JK-Future-GitHub/R2D2/png/R2D2_side.png

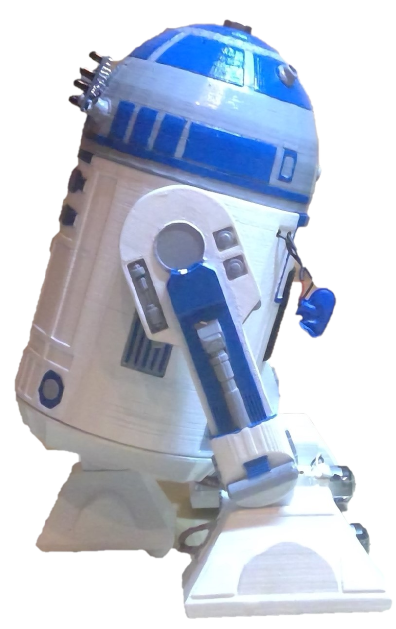
png/R2D2_side.png
