JK-Future-GitHub/R2D2/R2D2_doku_german.pdf

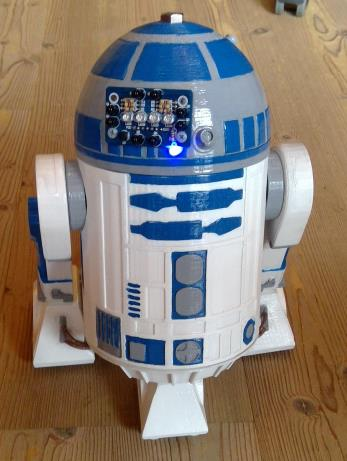
[picture p3: figure]

Bei meinen MCT-Projekt „R2D2“ habe ich mich optisch, wie auch aus technischer Sicht, an den

originalen Roboter aus den „Star Wars“ Filmen orientiert. Bei der Konstruktion handelt es sich,

um lackierten 3D-Druck. Die Elektronik, die den Roboter Leben ein verhaucht, wird zentral

über einen programmierten Mikrocontroller gesteuert. Dieser lässt sich via Bluetooth mit ei-

nen Smartphone verbinden und durch einer kompatiblen App ist es möglich den „R2D2“ steu-

ern.

Knauer Johannes

24.4.2018

R2D2

Nachbau des Originals

R2D2

Knauer Johannes | 1 von 23

## Inhaltsverzeichnis

## 1. Beschreibung der Idee

Bei der Ideenfindung war mir direkt klar, dass mein Projekt etwas mit Star Wars zu tun haben

muss, da ich ein Fan dieses „Universums“ bin und mit Hilfe eines Mikrocontrollers nachbauten

von Raumschiffen oder Robotern möglich sind. Zuerst war ein Landgleiter der Räder und Mo-

toren besitzt angedacht. Unteranderem sollte eine Objektverfolgung mit Hilfe eines speziellen

Sensors und einiger Programmierlogik realisiert werden. Des Weiteren steckte ich mir das Ziel,

den Gleiter mit ein Smartphone zu steuern.

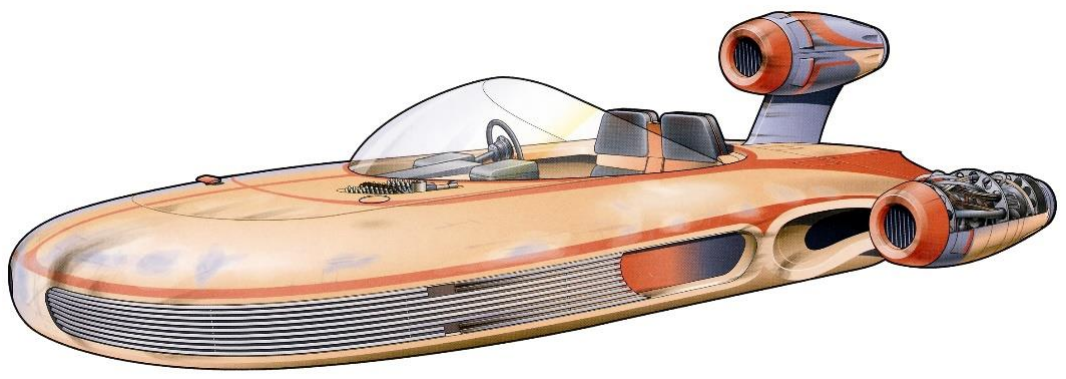
[picture p4: figure]

Abbildung 1: „Luke´s Landgleiter“

Es hat sich aber herausgestellt, dass der Landgleiter zu wenig Platz für alle Bauteile hatte, des-

halb musste eine neue Idee her. Auf der Internetseite www.thingiverse.com bin ich auf einen

rein mechanisch gesteuerten „R2D2“ gestoßen. (ChaosCorTech, 2018)

Dieser „R2D2“ wurde mit Hilfe eines 3D-Druckers hergestellt, die nötigen Informationen bzw.

Dateien stehen für jedermann zum Download bereit. Da mein Schulkollege, Blaufelder Daniel,

über so eine Vorrichtung verfügt, half er mir bei Umsetzung der Konstruktion und druckte mir

alle benötigten Bauteile.

Bis zur Fertigstellung dieser, beschäftigte ich

mich mit den elektrischen Bauteilen und ihrer

Programmierung. Durch den Bau zweier Pro-

totypen testete ich alle Bauteile, dadurch fie-

len mir weitere Funktionen ein, die ich um-

setzten könnte. Nach der Fertigstellung aller

zu druckenden Teilen, der Lackierung, den Zu-

sammenbau, der Verkabelung und Änderung

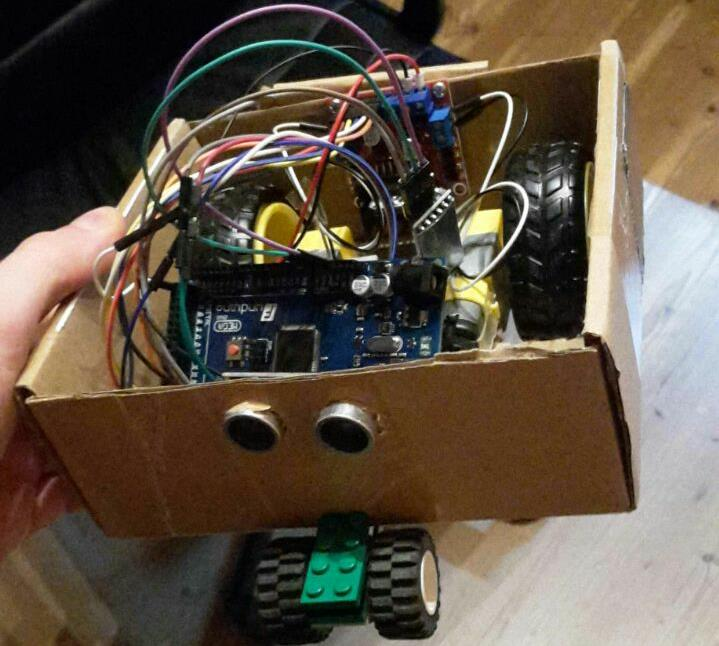
[picture p5: figure]

Abbildung 2: “Prototyp 1 von 2“ | vieler Kleinigkeiten verging eine Menge Zeit.

Doch schlussendlich erreichte ich alle Ziele/Funktionen die ich mir gesteckt habe.

Die Ziele waren:

- Via Bluetooth und Smartphone den „R2D2“ steuern
- Antrieb mit zwei DC-Motoren über die „H-Bridge/L298N“ regeln
- Objektverfolgung durch den „IR-Compound-Sensor“
- RGB-Led integrieren
- Kopfbewegungen mit den Servomotor „Tower Pro/MG995“ realisieren
- Die typischen Geräusche des „R2D2s“ über einen Lautsprecher ausgeben
- Mit den SD-Card-Reader die Geräusch-Dateien zur Verfügung stellen
- Optisch den Original so nahe wie möglich kommen

Als besonders „Zeitfressend“ stellte sich das lackieren, das Zusammenbringen aller elektri-

schen Bauteile und ausbessern von Kleinigkeiten heraus.

## 2. Funktionsbeschreibung

Der Bediener sendet Befehle über sein Smartphone an den Bluetooth-Empfänger bzw. den

Arduino-Board. Dort werden diese Signale verarbeitet und die zugeordneten Aktionen ausge-

führt.

Um die Funktionsweise bzw. die Logik hinter den komplizierteren Aktionen leichter zu verste-

hen, werde einige Bilder folgen. Aber zuerst ein paar Worte zu den „einfacheren“ Funktionen.

Die Funktion „Geräuschausgabe“ wird aus der Kombination des SD-Karten-Lesers und den

Lautsprecher realisiert.

Der Mikrocontroller bekommt die nötigen Informationen zur Geräuscherzeugung von der SD-

Karte und sendet die dementsprechenden Signale Richtung Lautsprecher.

Die „leuchtenden RGB-Led“ ist sehr simple, denn je nachdem welcher Pin „High“ ist, ändert

die Led ihre Farbe (Quellcode Zeile: 287-318).

Das Antriebssystem des „R2D2“ wird durch zwei DC-Motoren und einen Servomotor realisiert.

Antriebssystem:

→ siehe (QZ = 1-7)

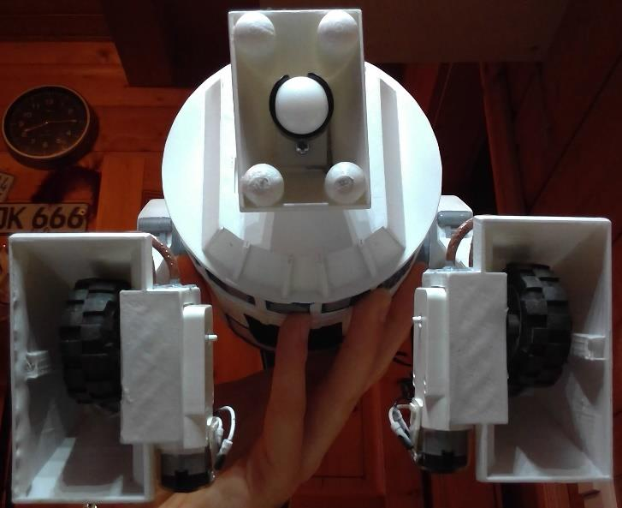
[picture p6: figure]

Abbildung 3: „DC-Motoren mit Räder und kugelförmiger Fuß“

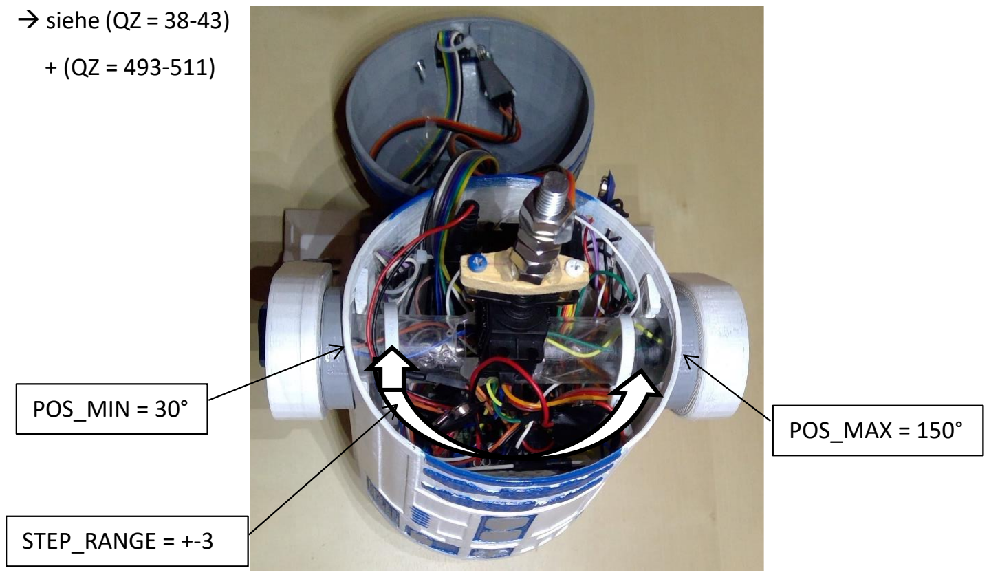
[picture p7: figure]
→ siehe (QZ = 38-43); POS_MIN = 30°; POS_MAX = 150°; STEP_RANGE = +-3

Abbildung 4: „Servo in Grundstellung = 90°“

Durch die Kombination des „Antriebssystems“ und des „IR-Compound-Eye“ kann eine Objekt-

verfolgung realisiert werden. Das „IR-Compound-Eye“ sendet mit seinen Infrarot-Leds ein kur-

zes Signal. Danach misst es die Konzentration der Strahlen, die vom Objekt zurück reflektiert

werden. Die unterschiedlichen positionierten Infrarotsensoren detektieren diese. Bei keinem

Infrarotanteil bekommt der Mikrocontroller die Signalstärke „0“ geliefert, bei maximaler

„1023“. (Analoger Eingang)

→ 1023 Objekt direkt vor den Sensor

→ 500 Objekt ca. 8-10cm entfernt

→ siehe (QZ = 23-31, 374-415)

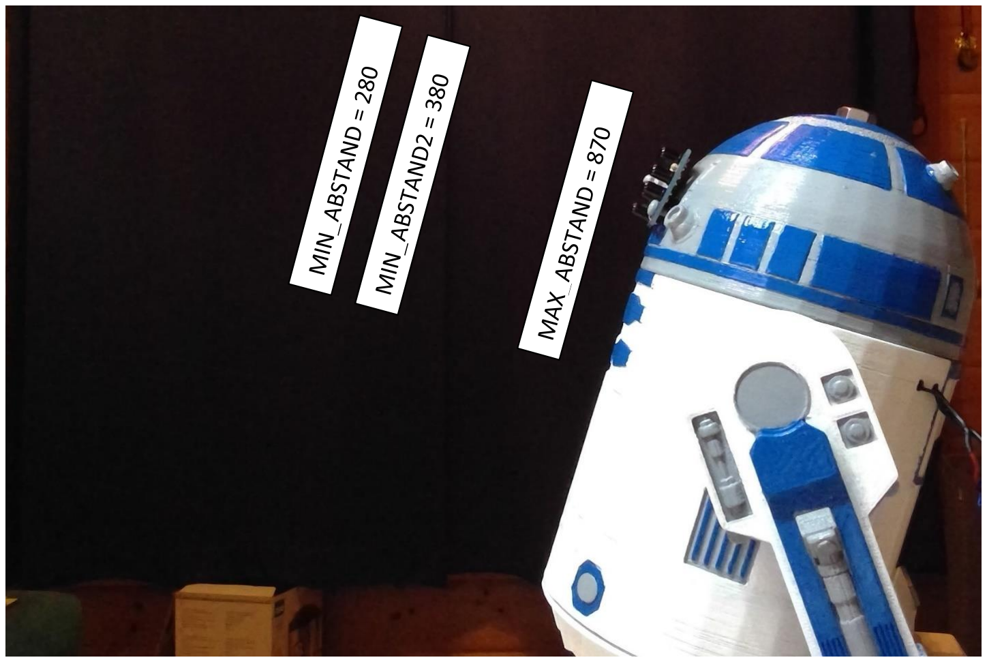
[picture p8: figure]

Um die Methode „followObject()“ (QZ = 374-415) leichter zu verstehen ist es hilfreich, sich die

Bilder und Variablen anzuschauen und mit den if-Abfragen bzw. den Bedingungen aus den

Quellcode bildlich zu verknüpfen.

Abbildung 5: „Abstände Objektverfolgung“

## 3. Beschreibung der Schaltung

Die Schaltung wurde im Programm „Fritzing“ angefertigt. Ich entschied mich dafür mehrere

Fritzing-Dateien anzufertigen. Zum einen, weil es bei so vielen Bauteilen/Leitungen sehr un-

übersichtlich wird. Zum anderen, weil das Programm immer wieder abstürzte, wenn ich alle

Bauteile in eine Schaltung zusammenbringen wollte. Deshalb fertigte ich vier Fritzing-Schal-

tungen an:

→ SD-Card-Reader

→ HC-05 + RGB LED

→ IR-Compound-Eye + H-Bridge

→ Lautsprecher + Servo

Der Verwendete „Arduion Mega 2560“, wie auch die „H-Bridge“ werden von einer 9V Block-

batterie mit Energie versorgt. Einige „GND“ und „5V“ Anschlüsse sind in der Realität verlötet,

das hat aber keinen Einfluss auf irgendwelche Funktion. Die vier kleinen Fritzing-Schaltungen

ergeben zusammen eine große. Der Quellcode ist sehr gut beschrieben, deshalb werde ich des

Öfteren darauf verweisen. Im Anschluss werde ich einige Besonderheiten ansprechen:

→ SD-Card-Reader:

Wenn man einen SD-Karten-Lesegerät verwendet, muss man je nach Mikrocontroller-Model

darauf achten, welche Geräteanschlüsse man auf welchen Mikrocontroller Pin setzt.

Arduino Mega 2560: (admin, 2018) (Quellcode Zeile: 49, 56-59)

→ Pin 53 = CS | → Pin 52 = SCK | → Pin 51 = MOSI | → Pin 50 = MISO

→ HC-05 + RGB LED:

Es gibt zwei verschiedene Ausführungen der RGB-Led, die eine hat eine Kathode, die Andere

eine Anode. Bei diesem Projekt handelt es sich, um die erst genannte. (Funduino, 2018)

(QZ: 61-66) Der Bluetooths Sender und Empfänger „HC-05“ hat zwei besondere Kommunika-

tionsanschlüsse. Den „TX“ und den „RX“ Anschluss. (Funduino, 2017) (QZ: 11-12)

→ Pin RX0 = TX → Pin TX0 = RX

→ IR-Compound-Eye + H-Bridge:

Die „H-Bridge“ kann zwei DC-Motoren gleichzeitig ansteuern. (Tech, Youtube, 2017) (QZ: 1-7)

Das „IR-Compound-Eye“ ist sehr Lichtempfindlich, da es selbst mit Infrarotstrahlen arbeitet.

(Robotrus, 2018) (QZ: 16-21)

→ Lautsprecher + Servo:

Der Servo „Tower/MG995“ ist ein Servo mit einer hohen Momenten Leistung, deshalb benö-

tigt er eine externe Energiequelle. (Funduino, 2018) (QZ: 38, 93) Der Lautsprecher zeigt Ge-

meinsamkeiten mit der SD-Karten-Erkennung, da dieser auch einen exakt vorbestimmten Aus-

gabe Pin benötigt und dieser wiederrum Modelabhängig ist. (GitHub, 2018)(QZ: 50, 52-54)

→ Mögliche Ausgabepins = 5|6|11|46

## 4. Beschreibung des Quellcodes

Der beiliegende Quellcode ist meiner Meinung nach sehr gut beschrieben. Die Kommentare

verraten beinahe alles über das Programmierte. Trotzdem werde ich noch genauer auf die

Bibliotheken, ihre Besonderheiten/Methoden und den ein oder anderen „Zeitfresser“ anspre-

chen. Die Pin-Belegung wurde teilweise von dem Mikrocontroller-Model oder von verwende-

ten Bibliotheken vorgegeben. (siehe < TMRpcm.h >)

Bibliotken und ihre Methoden:

→ <Servo.h> (Margolis, 2018) (QZ: 35)

Es kann ein „Servo-Objekt“ erzeugt werden mit dem man Methoden ausführen kann. (QZ: 36)

Zum Beispiel:

(QZ: 93)→ .attach(); Hier wird den Servo eine Steuerleitung zum Arduino-Board zugeteilt.

(QZ: 94)→ .write(); Hier wird den Servo ein Zielposition zugeteilt, die er anfährt. Dabei ist da-

rauf zu achten, dass der Servo eine Verfahr Zeit hat.

(QZ: 210)→ .read(); Hier wird die aktuelle Position des Servos ausgelesen.

Eine Besonderheit von der „write()“-Methode ist es, dass eine externe Variable mit den Inhalt

der runden Klammern beschrieben wird. Wenn die „read()“-Methode den aktuellen Wert aus-

lesen will, „checkt“ sie nicht den aktuellen Winkel des Servos, sondern nur die externe Vari-

able. Es kann zu Ablauffehlern kommen! (Mögliche Lösung: Verfahr Zeiten)

→ <SD.h> (SparkFun, 2018) (QZ: 52)

Es kann eine SD-Karte ausgelesen und Methoden ausgeführt werden.

Zum Beispiel:

(QZ: 99-105)→ SD.begin(CS); Hier wird der CS-Pin angesteuert, dadurch wird überprüft, ob

eine SD-Karte vorhanden ist. *Siehe „Beschreibung der Schaltung“ →SD-Card-Reader

(QZ: 47-49)→ In diesen Quellcode Zeilen gehe ich näher auf einige Besonderheiten zur SD-

Karten Formatierung und Liederkonvertierung ein. (Tech, YouTube, 2018) (audio.online-

convert, 2018)

→ <TMRpcm.h> (GitHub, 2018) (QZ: 53)

Es kann ein „Lautsprecher-Objekt“ erzeugt werden mit dem man Methoden ausführen kann.

(QZ: 54)

Zum Beispiel:

(QZ: 97)→ .speakerPin; Hier wird das Attribut „speakerPin“ des „Lautsprecher-Objektes“ eine

Steuerleitung zum Arduino-Board zugeteilt.

*siehe „Beschreibung der Schaltung“ → Lautsprecher + Servo

(QZ: 98)→ .setVolume(5); Hier wird die Lautstärke des Lautsprechers festgelegt mit „5“. Der

Minimalwert ist 0 und der Maximalwert ist 7.

(QZ: 197)→ .play(); Hier kann eine Datei von der SD-Karte abgespielt werden. Aber Achtung,

je nach Stand der Bibliothek, die man herunterlädt, darf der Dateiname nicht länger als 8 Zei-

chen sein.

(QZ: 320)→ .isPlaying(); Hier kann überprüft werden, ob sich der Lautsprecher aktuell im

Wiedergabemodus befindet, oder schon damit fertig ist.

Die Bibliothek hat eine Besonderheit, die man nicht übersehen sollte, denn wenn man einmal

die Methode „play()“ ausführt, werden die PWM/Timer 1 ,2 und 3 ausgeschaltet, um Störge-

räusche zu vermeiden.

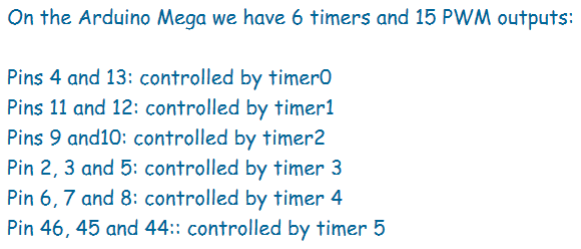
[picture p9: figure]

Abbildung 6: „PWM-Timer-Pins“

Das hat zur Folge, dass diese Pins im Anschluss nutzlos sind. Dies Besonderheit hat sich bei

meinem Projekt als echter „Zeitfresser“ erwiesen.

Hinweis: Ab der Quellcode Zeile „514“ befindet sich ein Methodenverzeichnis.

## 5. Bedienungsanleitung

Der „R2D2“ wird, wie schon erwähnt, über das Smartphone gesteuert. Die App die ich be-

nutzte heißt „Arduino bluetooth“. Der Aufbau der App

ist fast selbsterklärend. Nach der Installation und öff-

nen der App, wird man aufgefordert sein Bluetooth zu

aktivieren. Jetzt stellt man die Verbindung zum Blue-

tooth-Empfänger her. (HC_05)

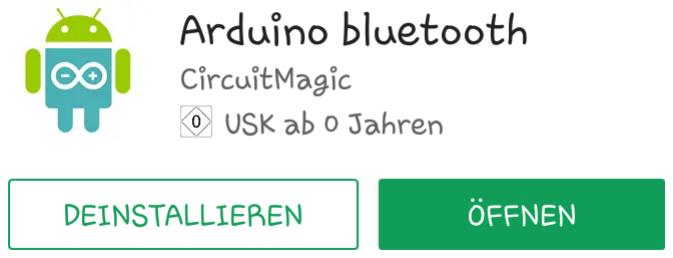
[picture p10: figure]

Man hat nun die Auswahl zwischen vier

Menüpunkten. (QZ = 114-118)

Der Quellcode bezieht sich nur auf die

Menüpunkte „Control pad“ und „But-

tons“.

Abbildung 7: „Arduino bluetooth“

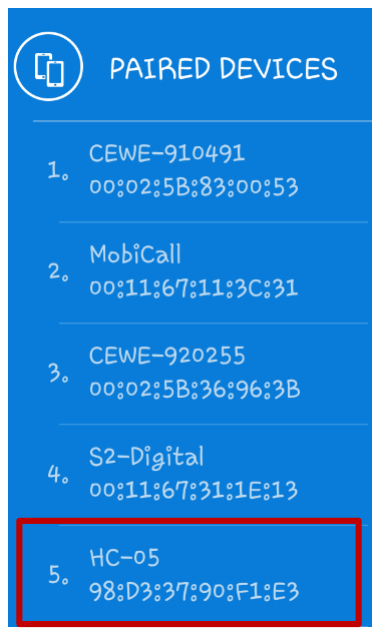
[picture p11: figure]
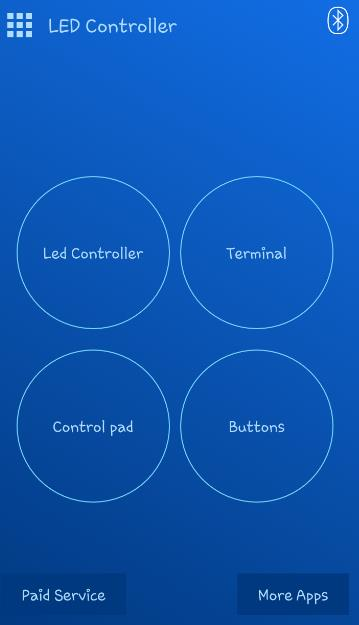
[picture p12: figure]

Abbildung 8: „Menü“ Abbildung 9: „Kopplungsmenü“

Menüpunkt „Control pad“: → siehe (QZ = 141-175)

Durch einen Klick auf das Bluetooth-Zei-

chen, kann die Verbindung getrennt

werden.

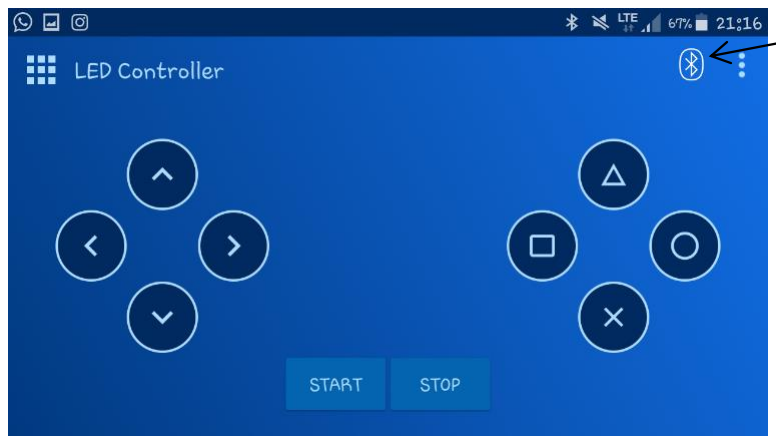
[picture p13: figure]

Bei einem Klick auf den Button mit den drei senkrecht zueinander laufenden Punkten, stellt

man die Zeichen, je Button ein. Jede Taste ist mit einem Zeichen hinterlegt.

→ Beispiel: - Abbildung 11: „Button Einstellung“

Menüpunkt „Buttons“: → siehe (QZ = 176-188)

Abbildung 10: „Control pad“

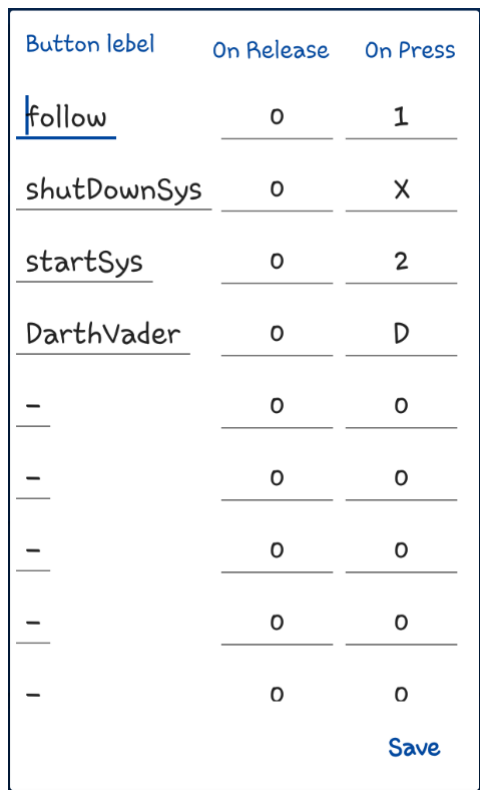
[picture p14: figure]
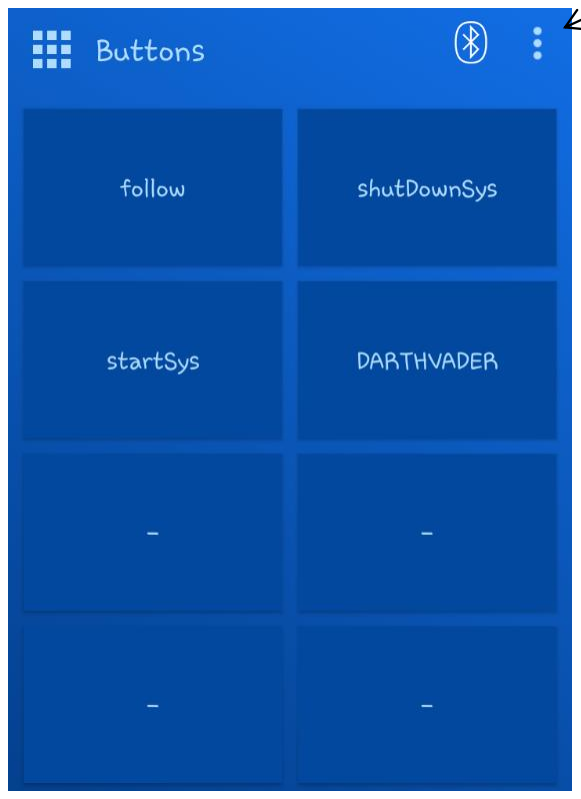
[picture p15: figure]

Abbildung 12: „Buttons“ | Abbildung 11: „Button Einstellung“

## 6. Quellenverzeichnis

### 6.1. Literaturverzeichnis

admin. (23. Februar 2018). Bajdi.com. Von http://www.bajdi.com/arduino-mega-2560-andsd-card-modul/ abgerufen

audio.online-convert. (19. Januar 2018). Von https://audio.online-convert.com/convert-towav abgerufen

ChaosCorTech. (17. Januar 2018). Thingiverse. Von https://www.thingiverse.com/thing:1205821 abgerufen

Funduino. (15. Dezember 2017). Von https://funduino.de/tutorial-hc-05-und-hc-06-bluetooth abgerufen

Funduino. (15. März 2018). Von https://funduino.de/nr-20-rgb-led abgerufen

Funduino. (19. Januar 2018). Von https://funduino.de/nr-12-servo-ansteuern abgerufen

GitHub. (19. Januar 2018). Von https://github.com/TMRh20/TMRpcm/wiki abgerufen

Margolis, M. (20. Januar 2018). ArduinoCC. Von
https://www.arduino.cc/en/Reference/Servo abgerufen

Robotrus. (15. Januar 2018). Von https://www.robot-r-us.com/sensor-infrared/ir-compoundeye.html abgerufen

SparkFun. (23. Februar 2018). ArduinoCC. Von https://www.arduino.cc/en/Reference/SD abgerufen

Tech, M. A. (15. Dezember 2017). Youtube. Von https://www.youtube.com/watch?v=Da4HY7HZ6h0 abgerufen

Tech, M. A. (20. Februar 2018). YouTube. Von https://www.youtube.com/watch?v=gi9mqIha8n0 abgerufen

### 6.2. Bilderverzeichnis

## 7. Anhang

### 7.1. Quellcode inkl. Zeilenzahlen

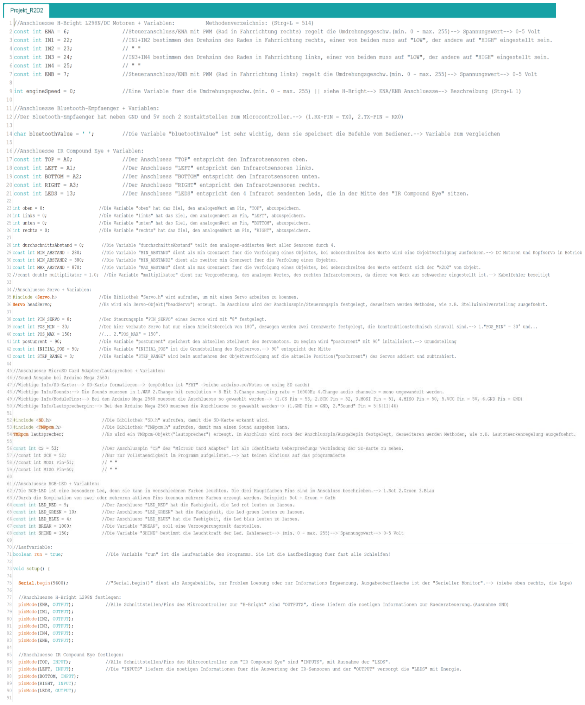
[picture p16: figure]

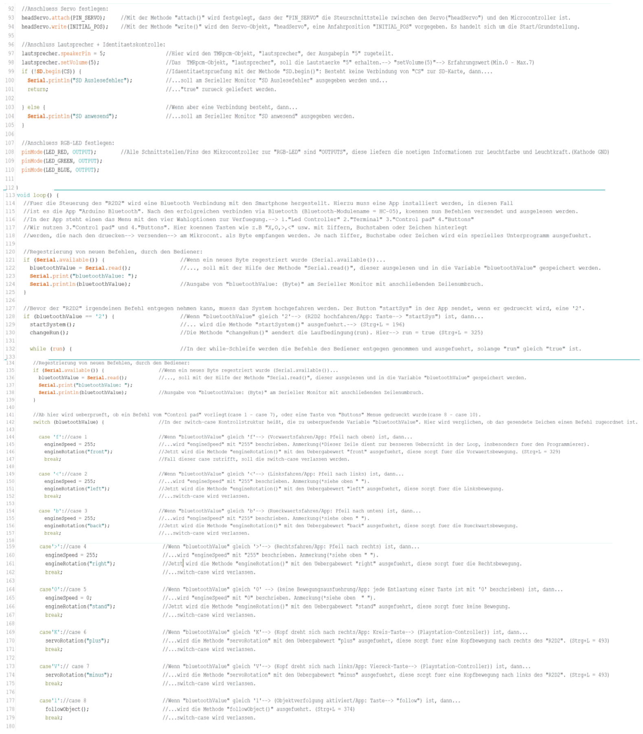
[picture p17: figure]
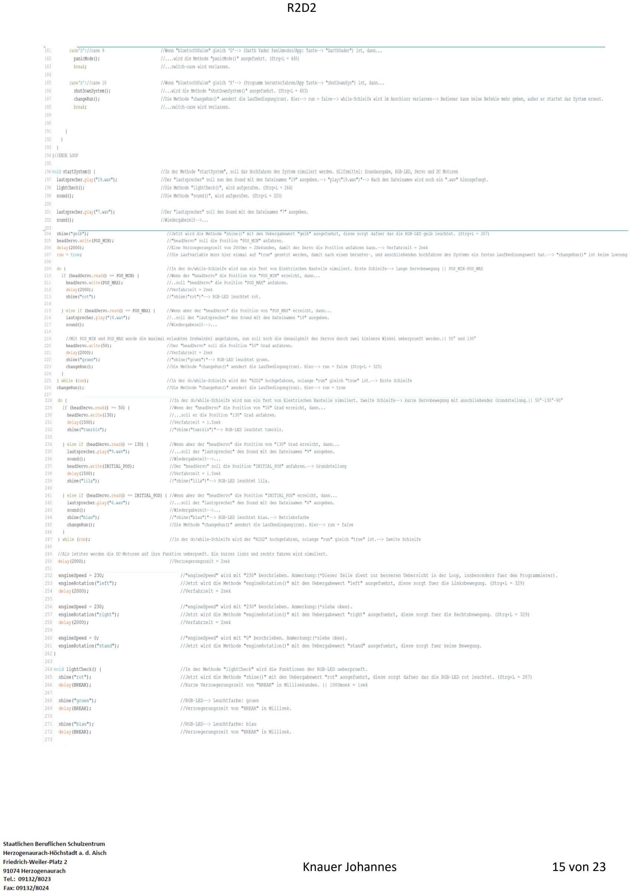
[picture p18: page 16]
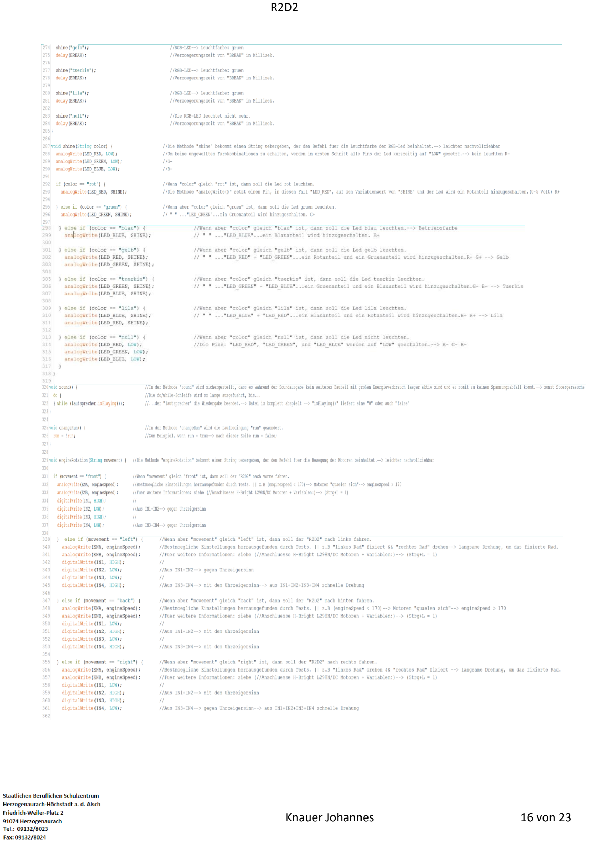
[picture p19: page 17]

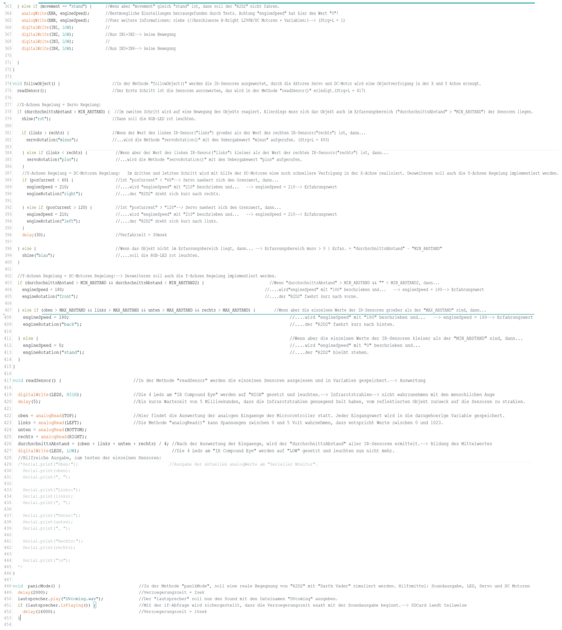
[picture p20: figure]

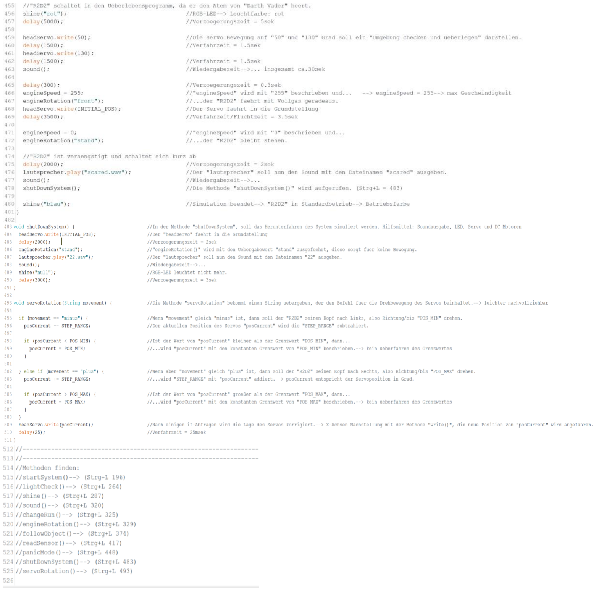
[picture p21: figure]
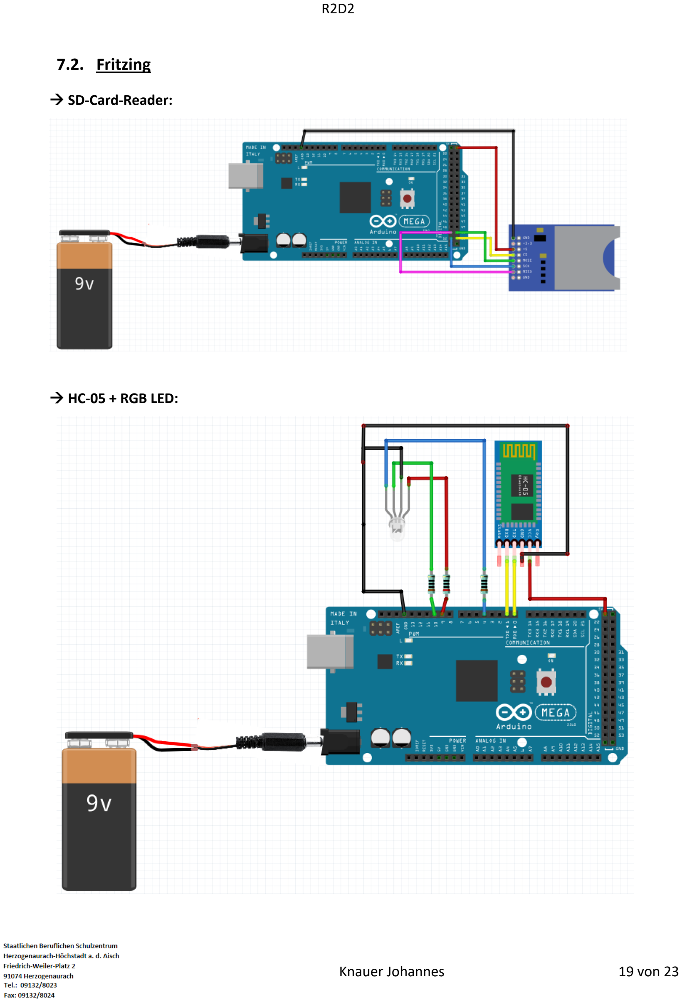
[picture p22: page 20]

### 7.2. Fritzing

→ SD-Card-Reader:

→ HC-05 + RGB LED:

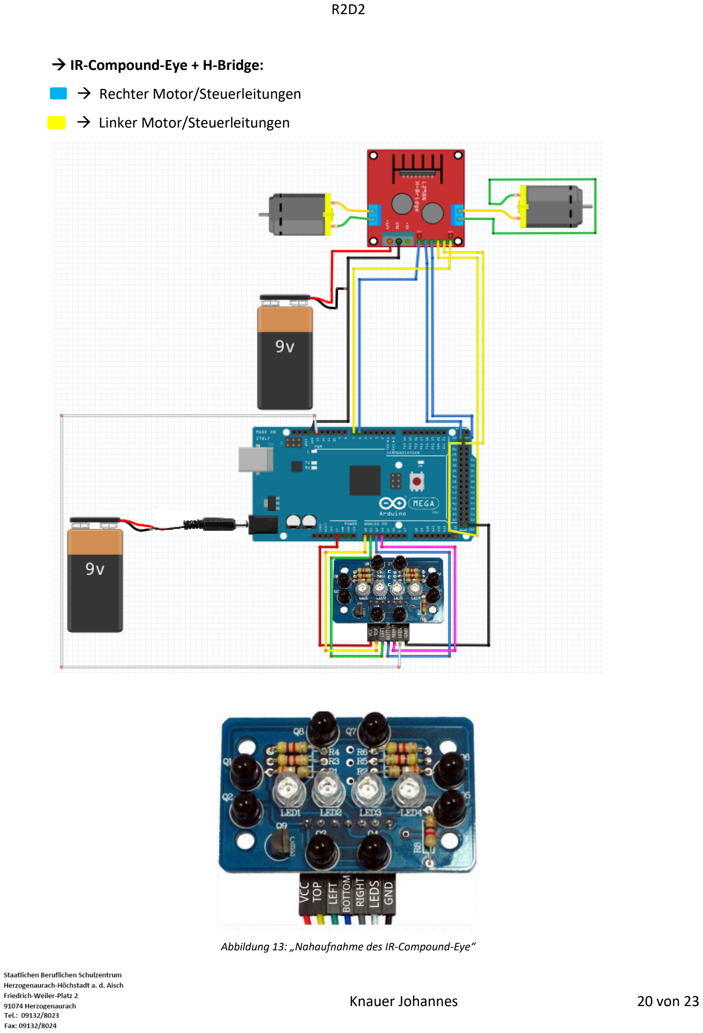
[picture p23: page 21]

→ IR-Compound-Eye + H-Bridge:

→ Rechter Motor/Steuerleitungen

→ Linker Motor/Steuerleitungen

Abbildung 13: „Nahaufnahme des IR-Compound-Eye“

→ Lautsprecher + Servo:

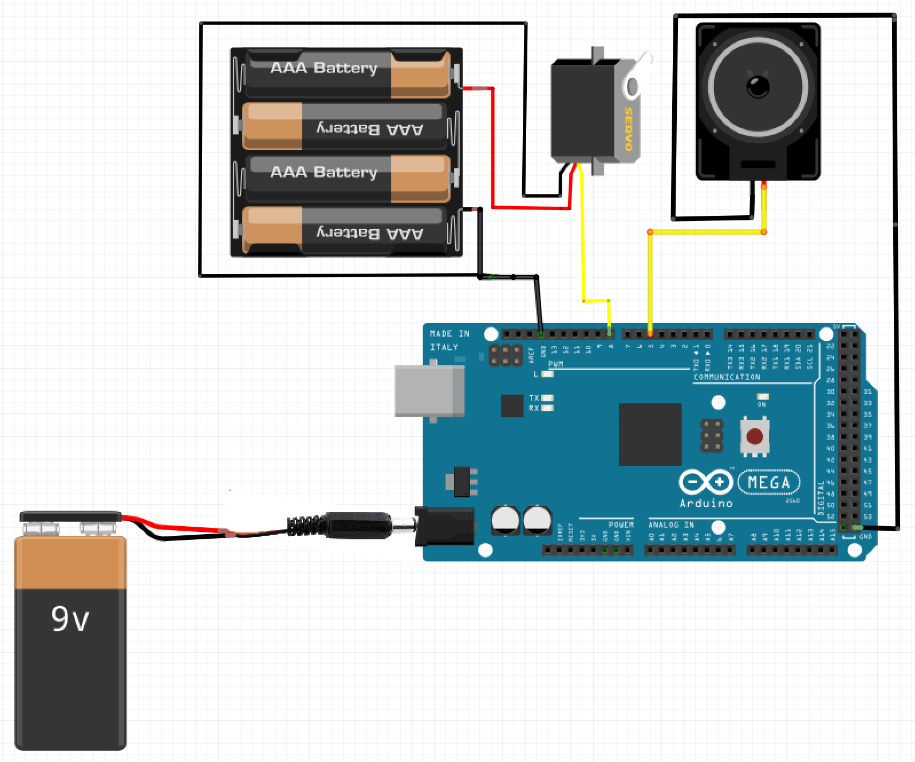
[picture p24: figure]

### 7.3. Zeitplanung

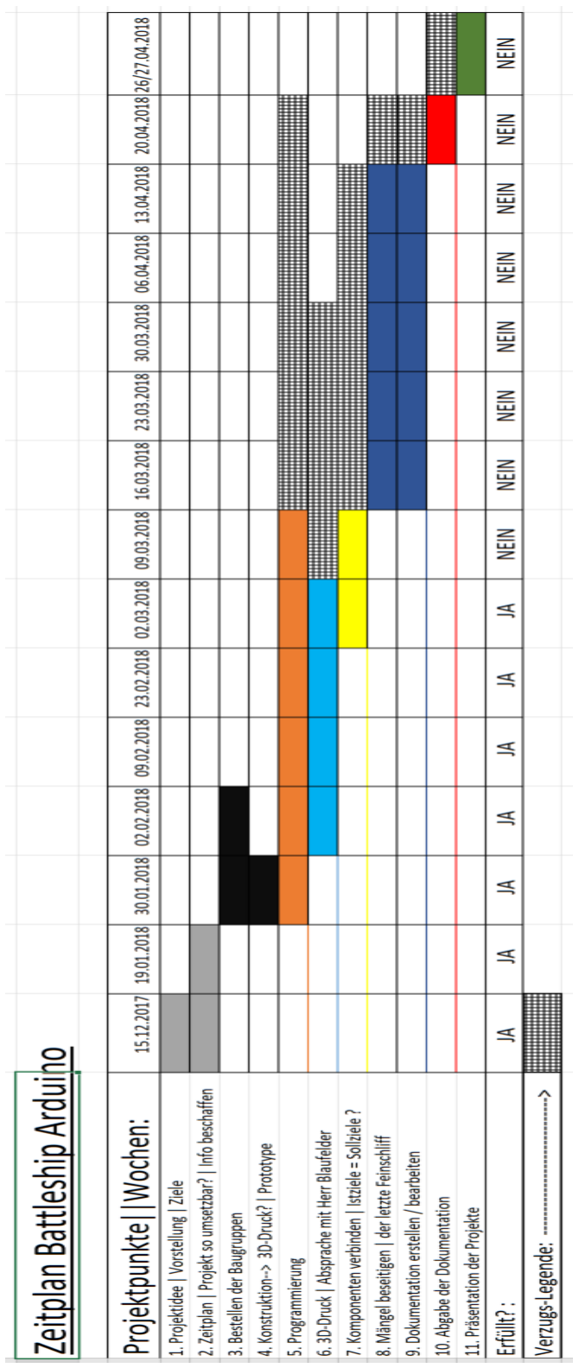
[picture p25: figure]

### 7.4. Erklärung mit Unterschrift

Ich versichere durch meine Unterschrift, dass ich die vorstehende Arbeitselbständig und ohne

fremde Hilfe angefertigt, alle Stellen, die ich wörtlich oder annähernd wörtlich aus Veröffent-

lichungen entnommen, als solche kenntlich gemacht und mich auch keiner anderen als der

angegebenen Literatur oder sonstiger Hilfsmittel bedient habe. Die Arbeit hat in dieser oder

ähnlicher Form noch keiner anderen Prüfungsbehörde vorgelegen.

Herzogenaurach den 24.4.2018

Knauer Johannes
