JK-Future-GitHub/R2D2/circuit_diagram/HC-05 +RGB LED.PNG

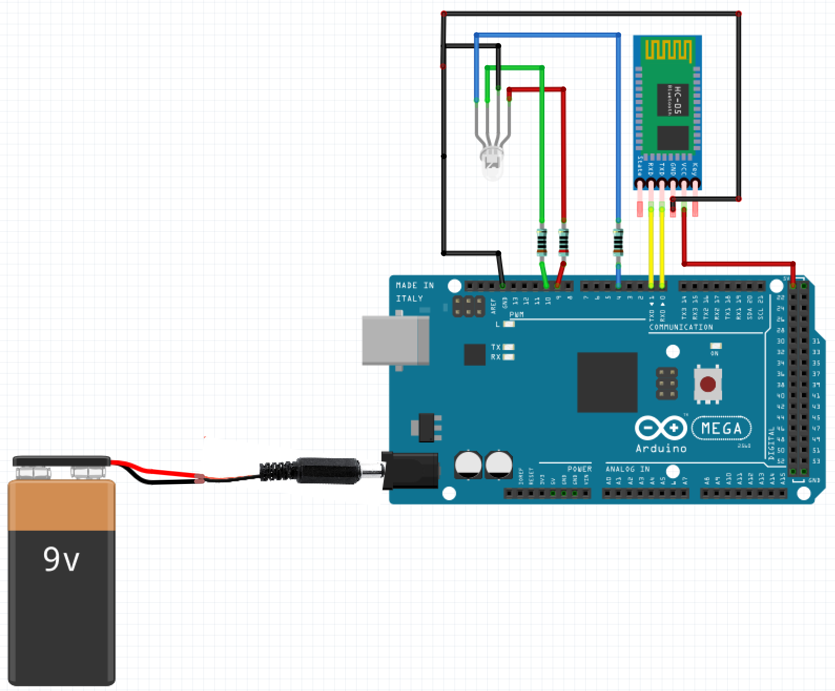
circuit_diagram/HC-05 +RGB LED.PNG
