JK-Future-GitHub/R2D2/circuit_diagram/IR-Compound-Eye + H-Bridge.PNG

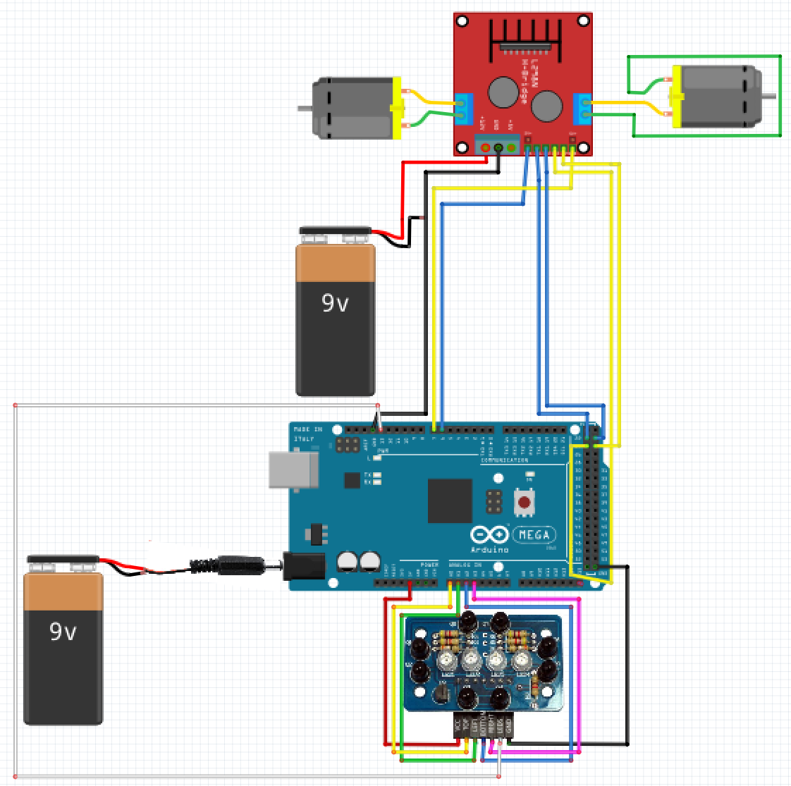
circuit_diagram/IR-Compound-Eye + H-Bridge.PNG
