JK-Future-GitHub/R2D2/circuit_diagram/IR_COMPOUND_EYE.PNG

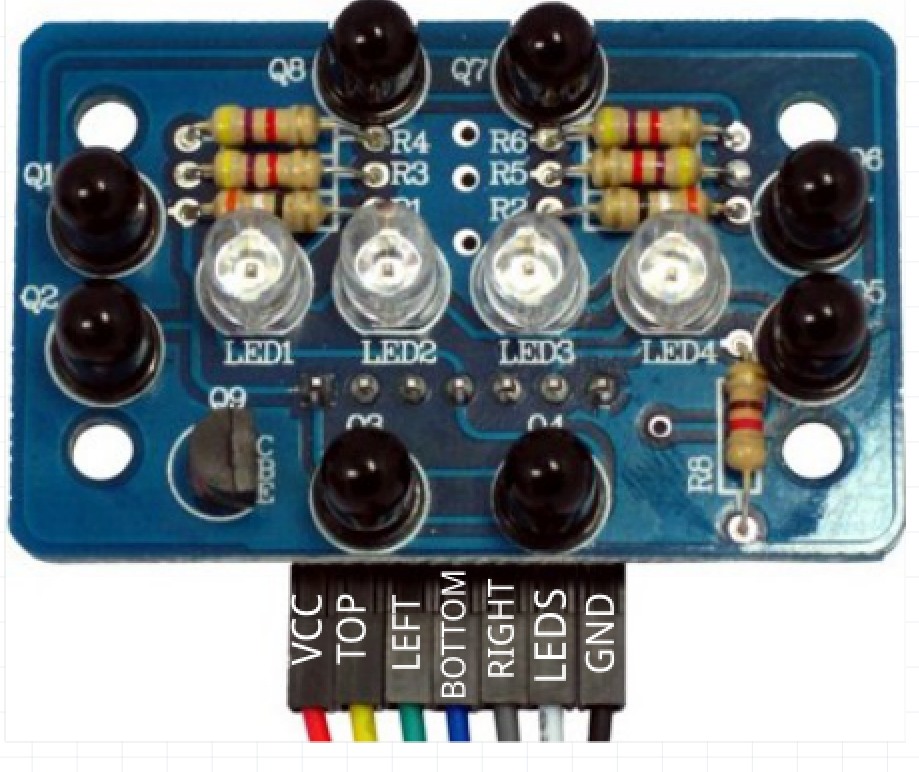
circuit_diagram/IR_COMPOUND_EYE.PNG
