JK-Future-GitHub/R2D2/circuit_diagram/SD-Card-Reader_Steckplatine.PNG

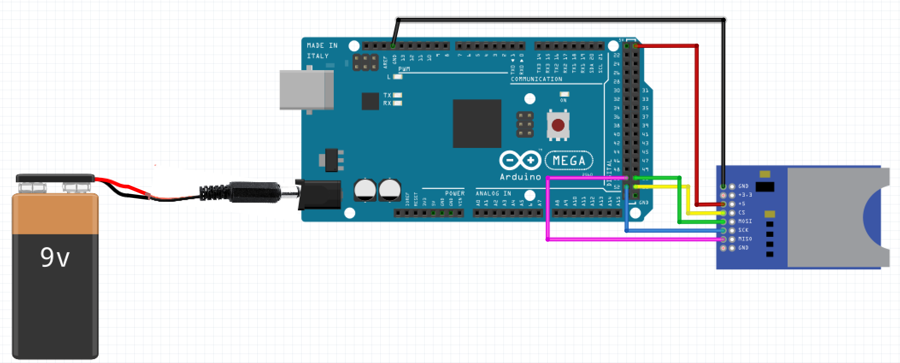
circuit_diagram/SD-Card-Reader_Steckplatine.PNG
