JK-Future-GitHub/R2D2/png/R2D2_front.png

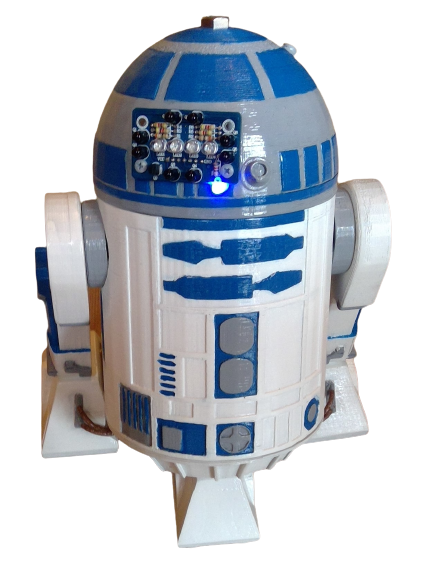
png/R2D2_front.png
