JK-Future-GitHub/R2D2/png/Screenshot_2018-04-22-21-15-07.png

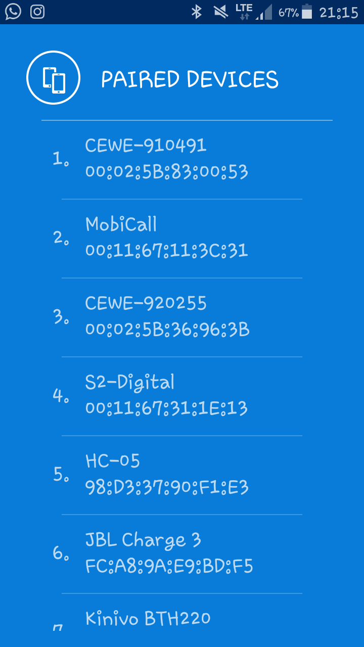
png/Screenshot_2018-04-22-21-15-07.png
