JK-Future-GitHub/R2D2/png/TMRpcm functions.PNG

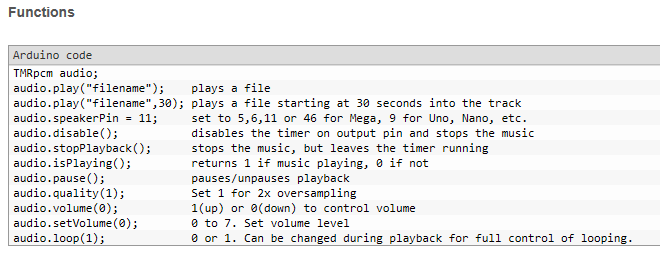
png/TMRpcm functions.PNG
